Sirjew2/Handheld-Device/README.txt

#This is the GitHub repository for the CRT 420 Advanced Prototyping Class.
