Sirjew2/Handheld-Device/Documentation/00-ProjectPoster.pdf

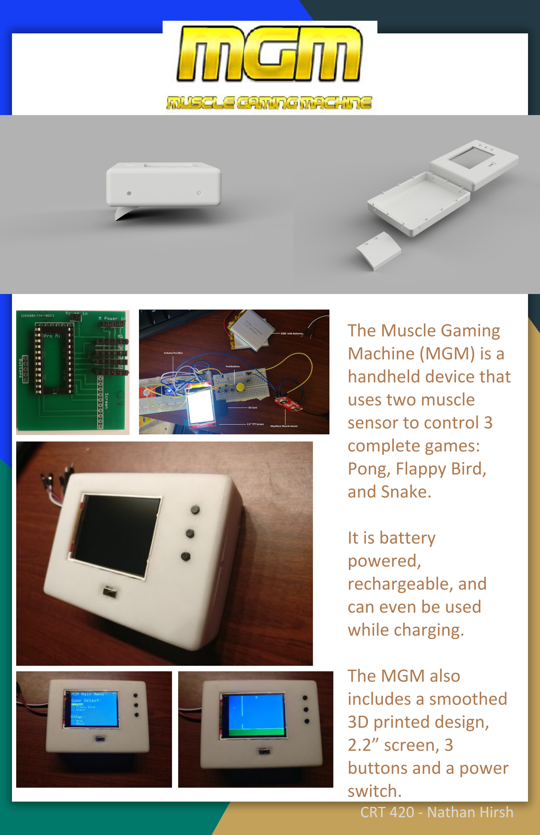
[picture p1: page 1]

The Muscle Gaming
Machine (MGM) is a
handheld device that
uses two muscle
sensor to control 3
complete games:
Pong, Flappy Bird,
and Snake.

It is battery
powered,
rechargeable, and
can even be used
while charging.

The MGM also
includes a smoothed
3D printed design,
2.2” screen, 3
buttons and a power
switch.
CRT 420 - Nathan Hirsh
