Sirjew2/Handheld-Device/Documentation/08-FormProduction.pdf

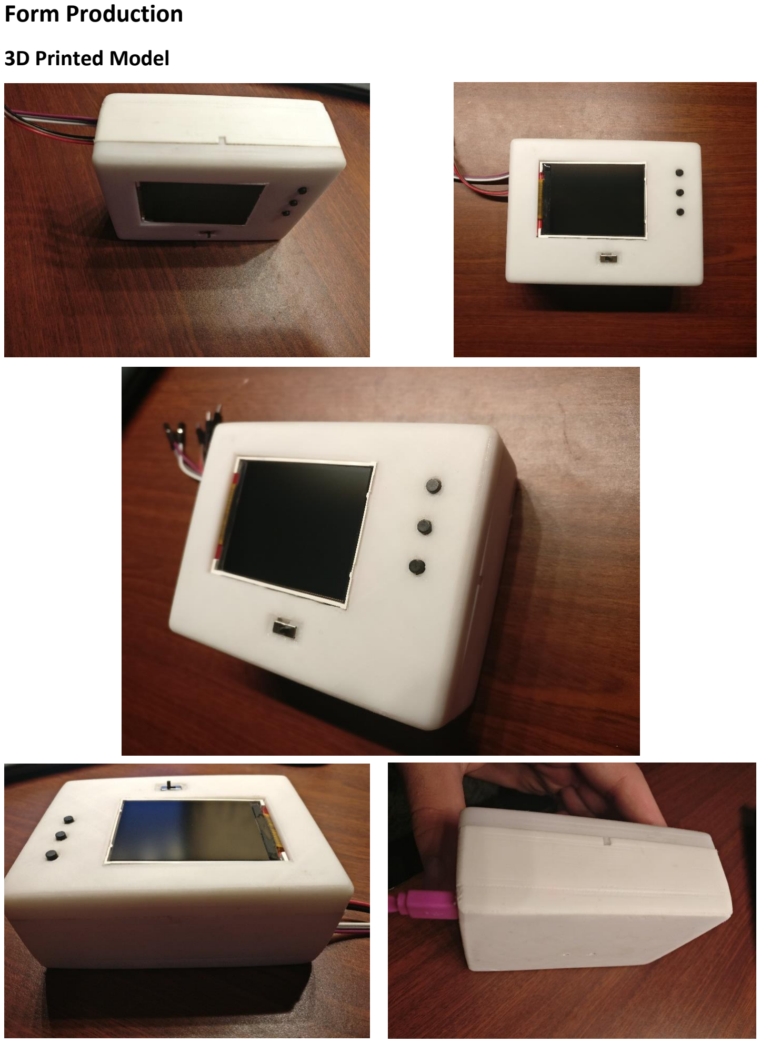
[picture p9: page 1]

Form Production

3D Printed Model
