Sirjew2/Handheld-Device/Documentation/07-FunctionProduction.pdf

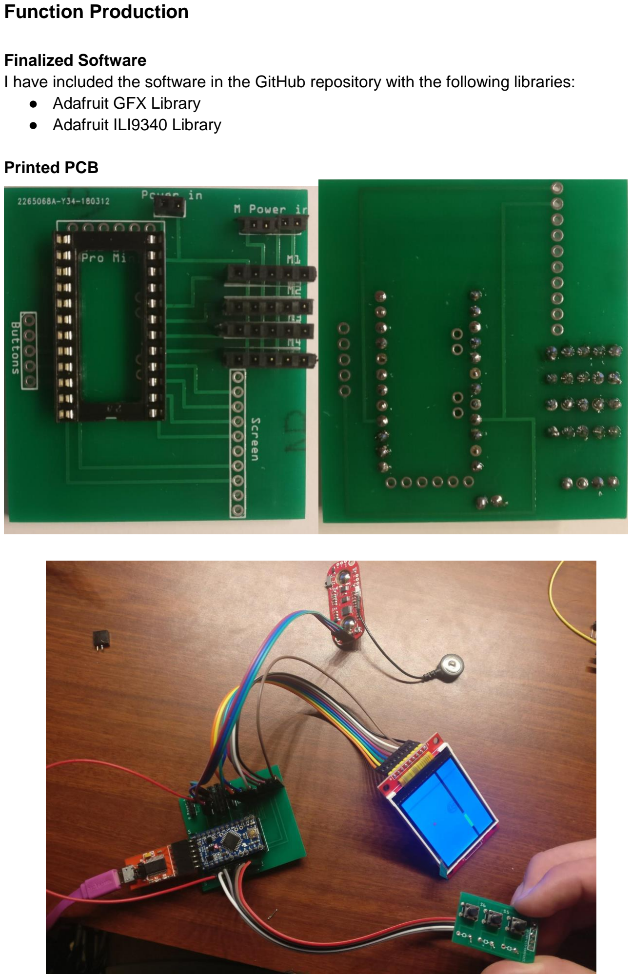
[picture p10: page 1]

Function Production

Finalized Software
I have included the software in the GitHub repository with the following libraries:
- Adafruit GFX Library
- Adafruit ILI9340 Library

Printed PCB
