Sirjew2/Handheld-Device/Documentation/09-Finalization.pdf

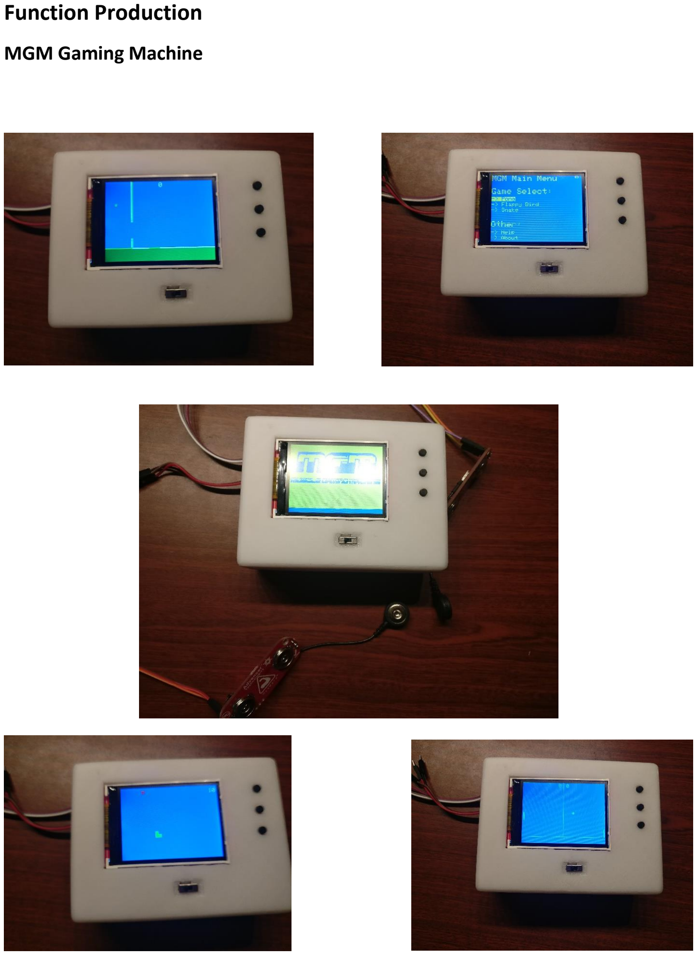
[picture p24: page 1]

Function Production

MGM Gaming Machine

User Testing:

User 1:

- Enjoyed playing each of the 3 games
- Loved the style and design
- Liked the way muscles were used to play
- Got a little fatigued playing flappy bird
- Would play again for fun

User 2:

- Said all of the games were fun to play
- Did not like how flappy bird froze sometimes
- The bottom half could be a bit smoother
- Enjoyed the style of muscle gaming
- Would play again and would recommend to friends

User 3:

- Really had fun playing on MGM
- Like the design
- Appreciated the splash screen design
- Said it was a great idea to play with muscles
- Pads hurt when they took them off
- Liked it, but wouldn’t play it very often
