Sirjew2/Handheld-Device/Documentation/06-FormProof.pdf

Form Proof of Concept

Refined Dimensioned Sketches

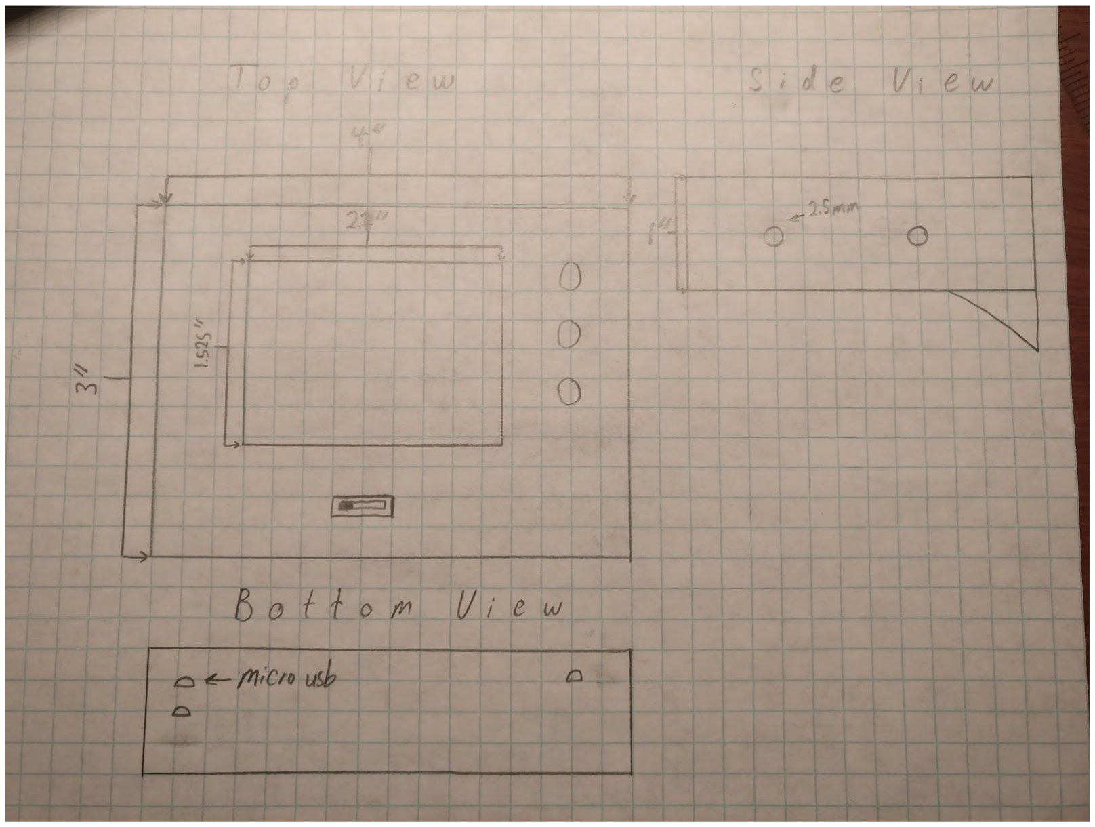
[picture p25: figure]
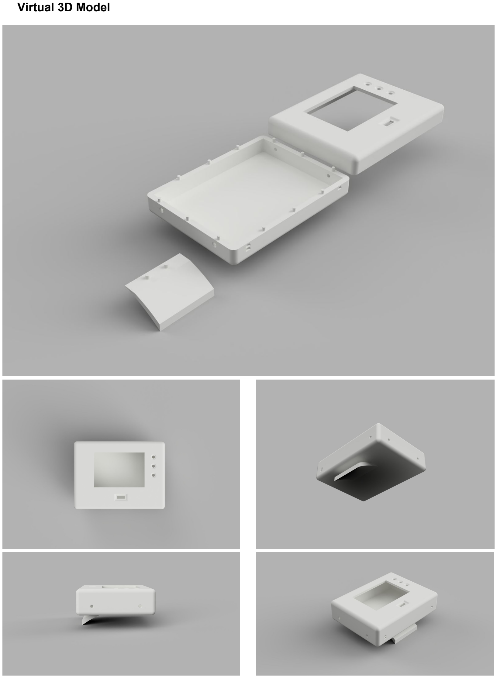
[picture p26: page 2]

Virtual 3D Model
