Sirjew2/Handheld-Device/(threads)

Thread 1 (2018-01-28):

02 Feedback

zanecochran, 2018-01-28:
I really like the idea of incorporating muscle sensors into an interactive game experience. There are a few things to consider though. I would have liked to have seen a bit more variation in the form factor ideas that you sketched out. Also, I've looked around for various muscle sensors, and it appears that we may be hitting a cost issue with sensors. One sensor ($37) looks like it can only handle one muscle, so to outfit a device with 4 sensors will become prohibitively expensive. Perhaps you could implement the sensor into the game as a way to trigger a special power? For example, you have to flex for a few seconds to charge up a power meter and fire a big energy ball or something.
