Sirjew2/Handheld-Device/(list of files, drawings)

Other design files:
PCB/Capstone.fzz
PCB/Full PCB Design.fzz
